slipwolff/TU821-1-RoboSumo-Project/README.md

# TU821-1-RoboSumo-Project
All files related to the TU805 RoboSumo Project were be uploaded here.
