slipwolff/TU821-1-RoboSumo-Project/(commit log)

2024-01-31 Upload LED Flash Challenge Code
2024-01-31 Upload LED Flash Challenge Resources
2024-01-31 Updated LED Flash Challenge.ino Added missing comments
    [LED Flash Challenge.ino]
