slipwolff/TU821-1-RoboSumo-Project/Blog Archive/Resources/Assembly Part 1.jpg

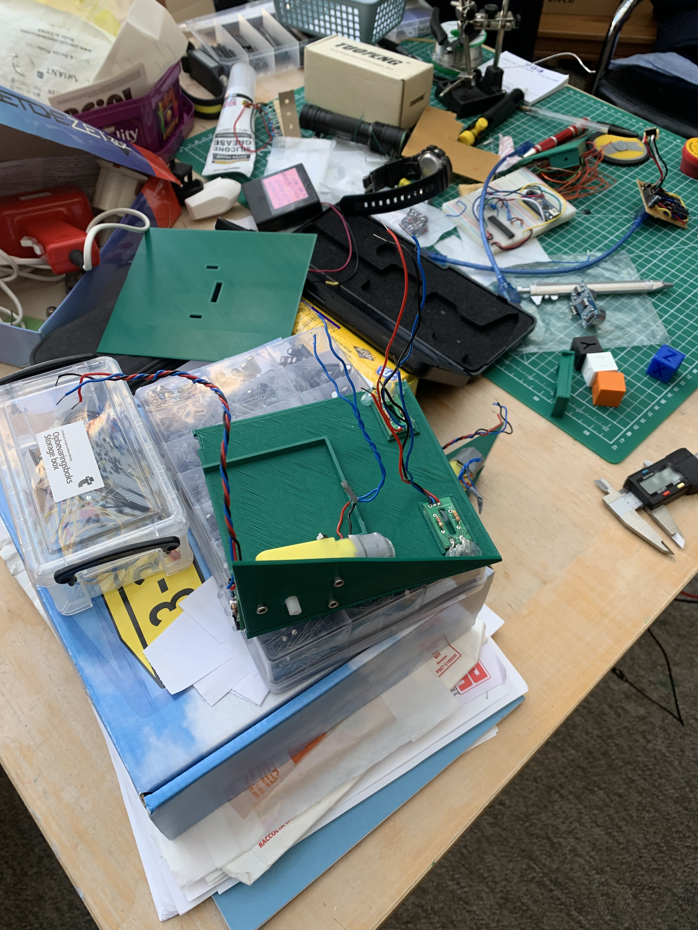
[picture p26: Blog Archive/Resources/Assembly Part 1.jpg]
Blog Archive/Resources/Assembly Part 1.jpg
